jeffsponaugle/Kartana3/images/ALUSchematicPage1.png

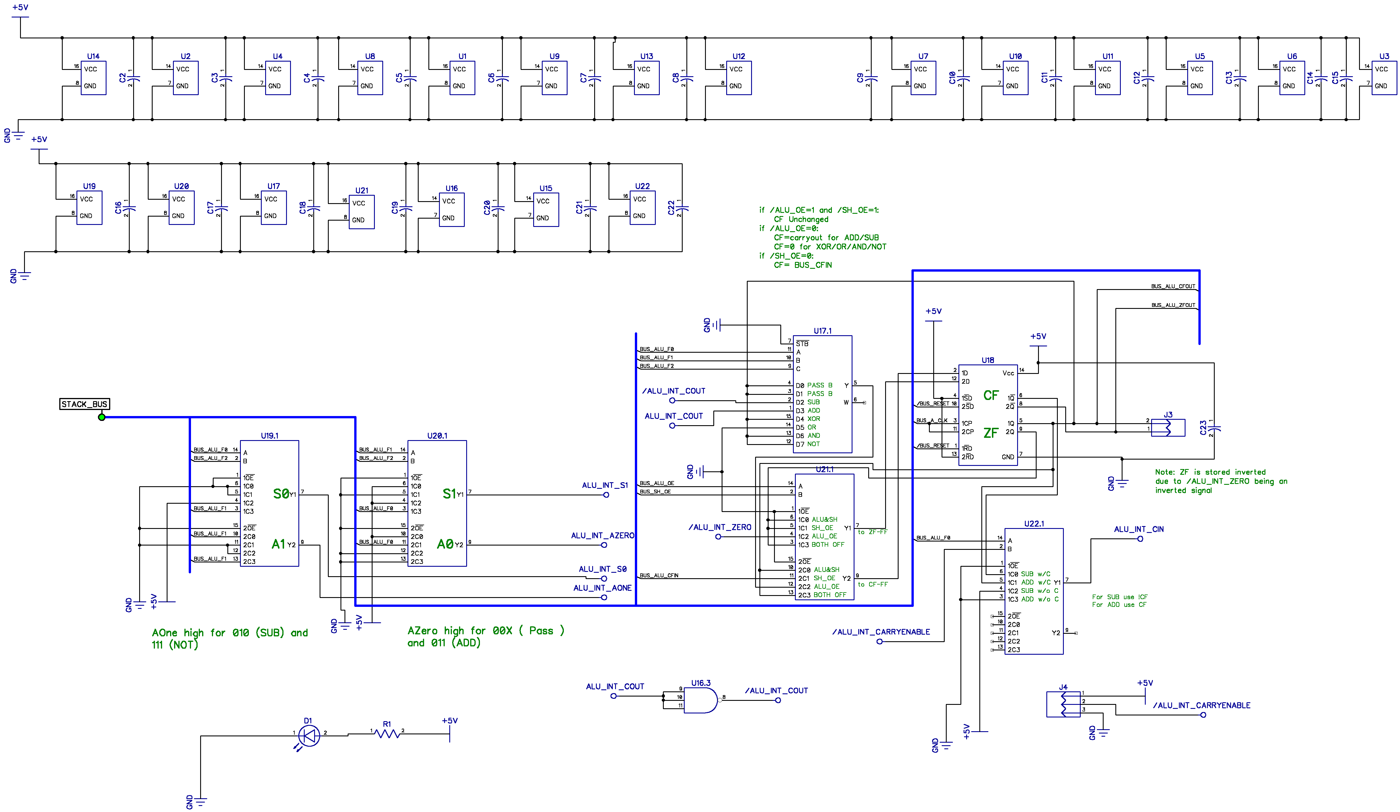
images/ALUSchematicPage1.png
