jeffsponaugle/Kartana3/images/ALUSchematicPage2.png

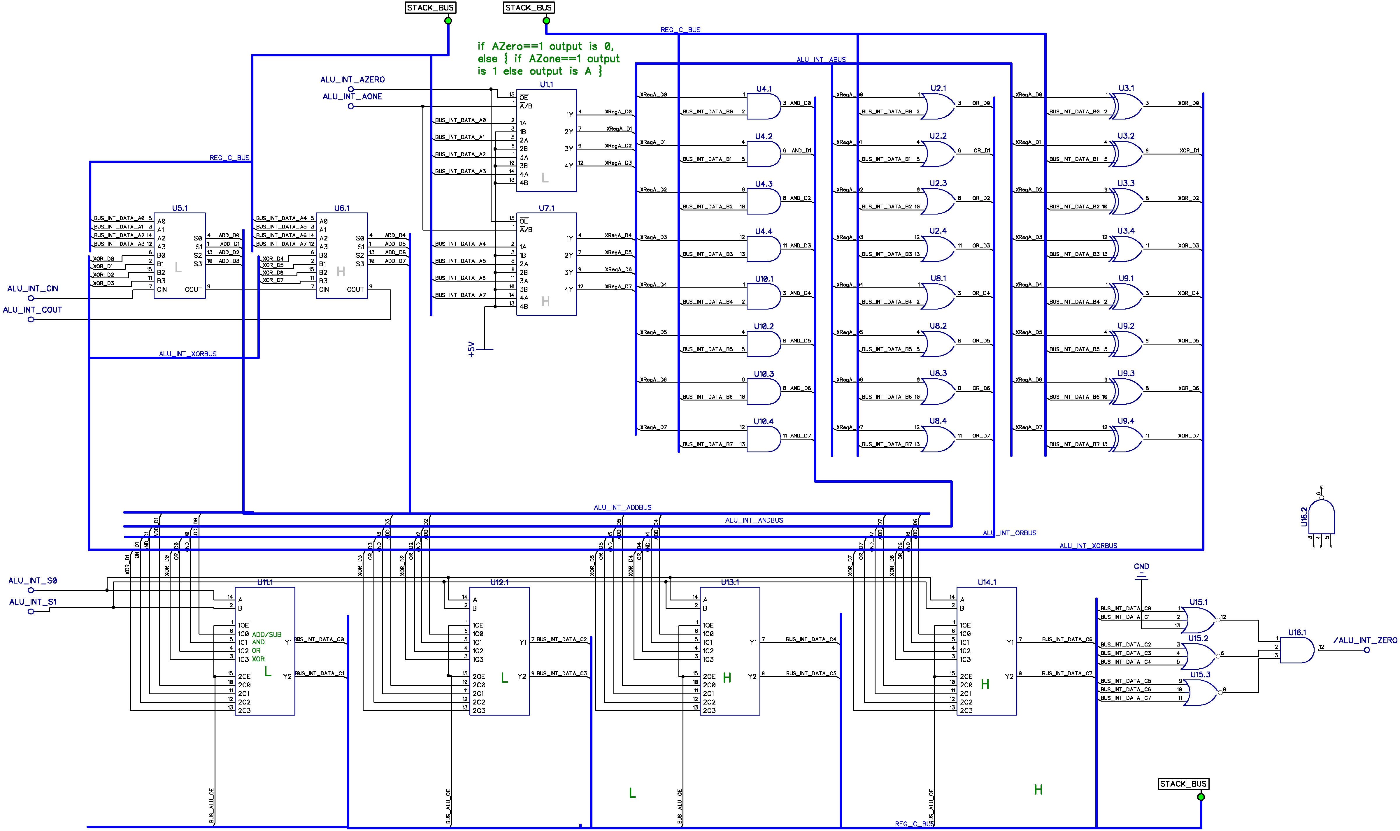
images/ALUSchematicPage2.png
