jeffsponaugle/Kartana3/images/MemoryPage1.png

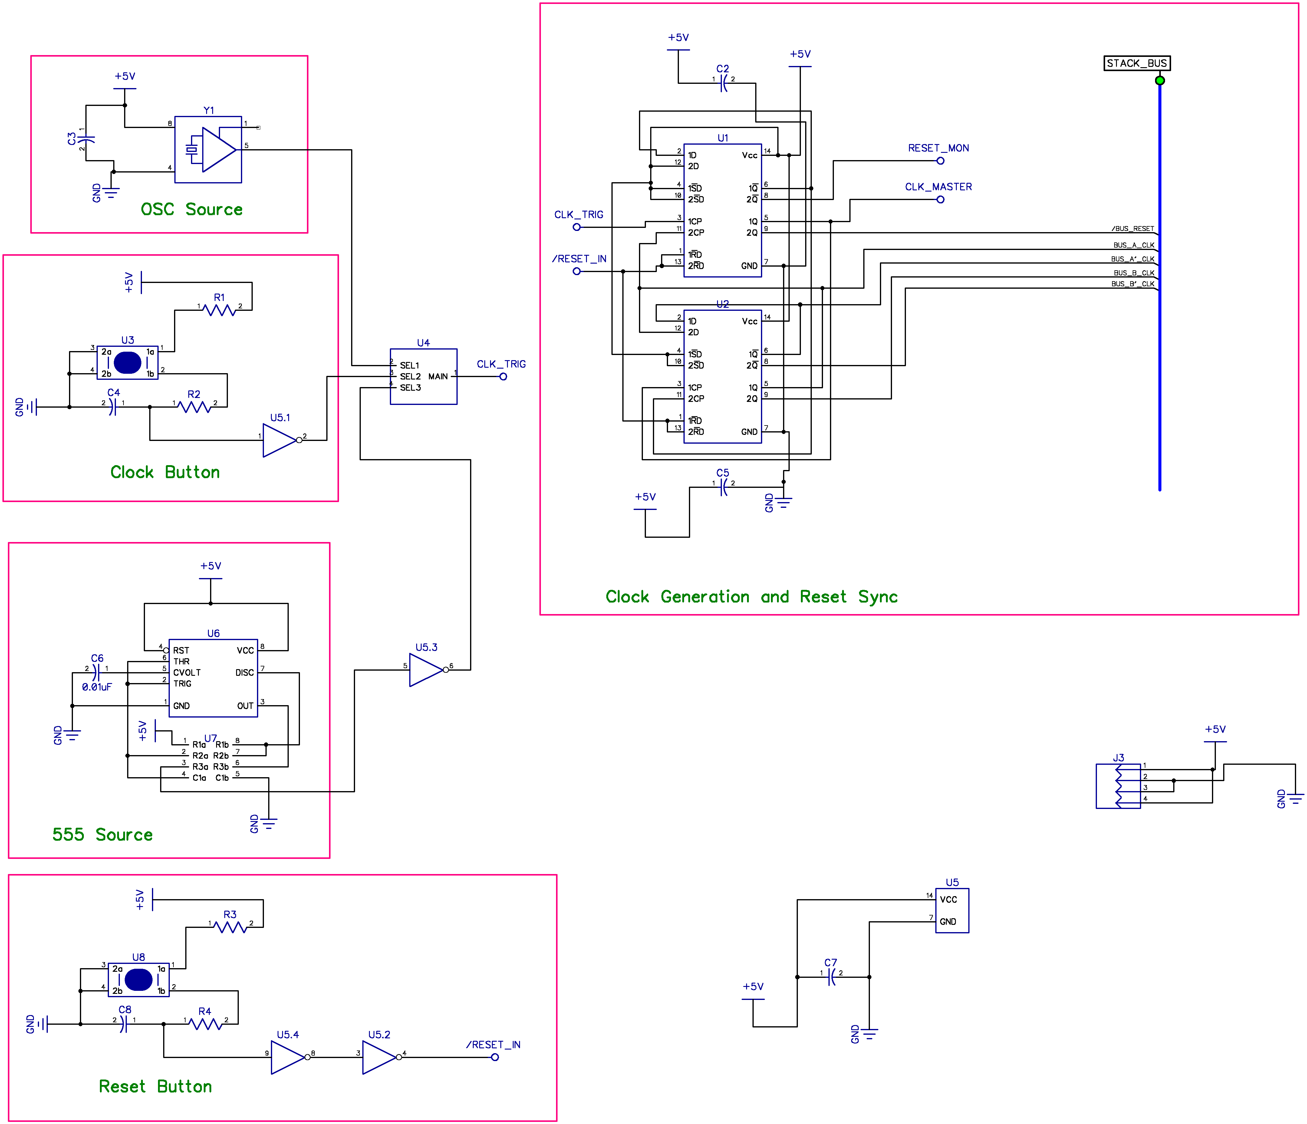
images/MemoryPage1.png
