jeffsponaugle/Kartana3/images/MemoryPage2.png

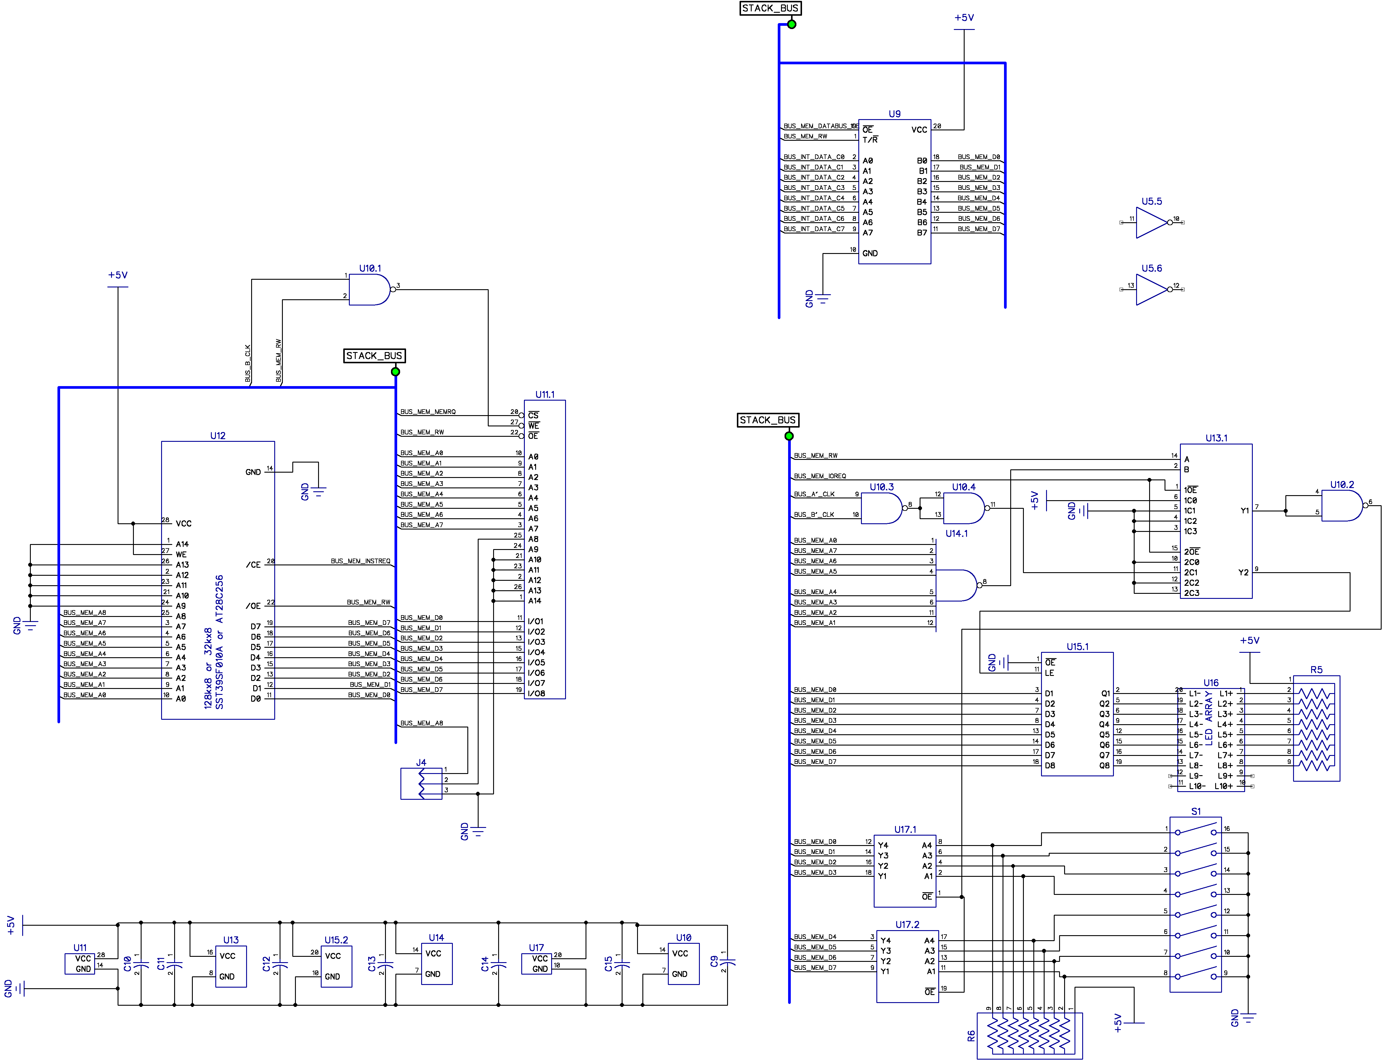
images/MemoryPage2.png
