jeffsponaugle/Kartana3/images/MemoryPage3.png

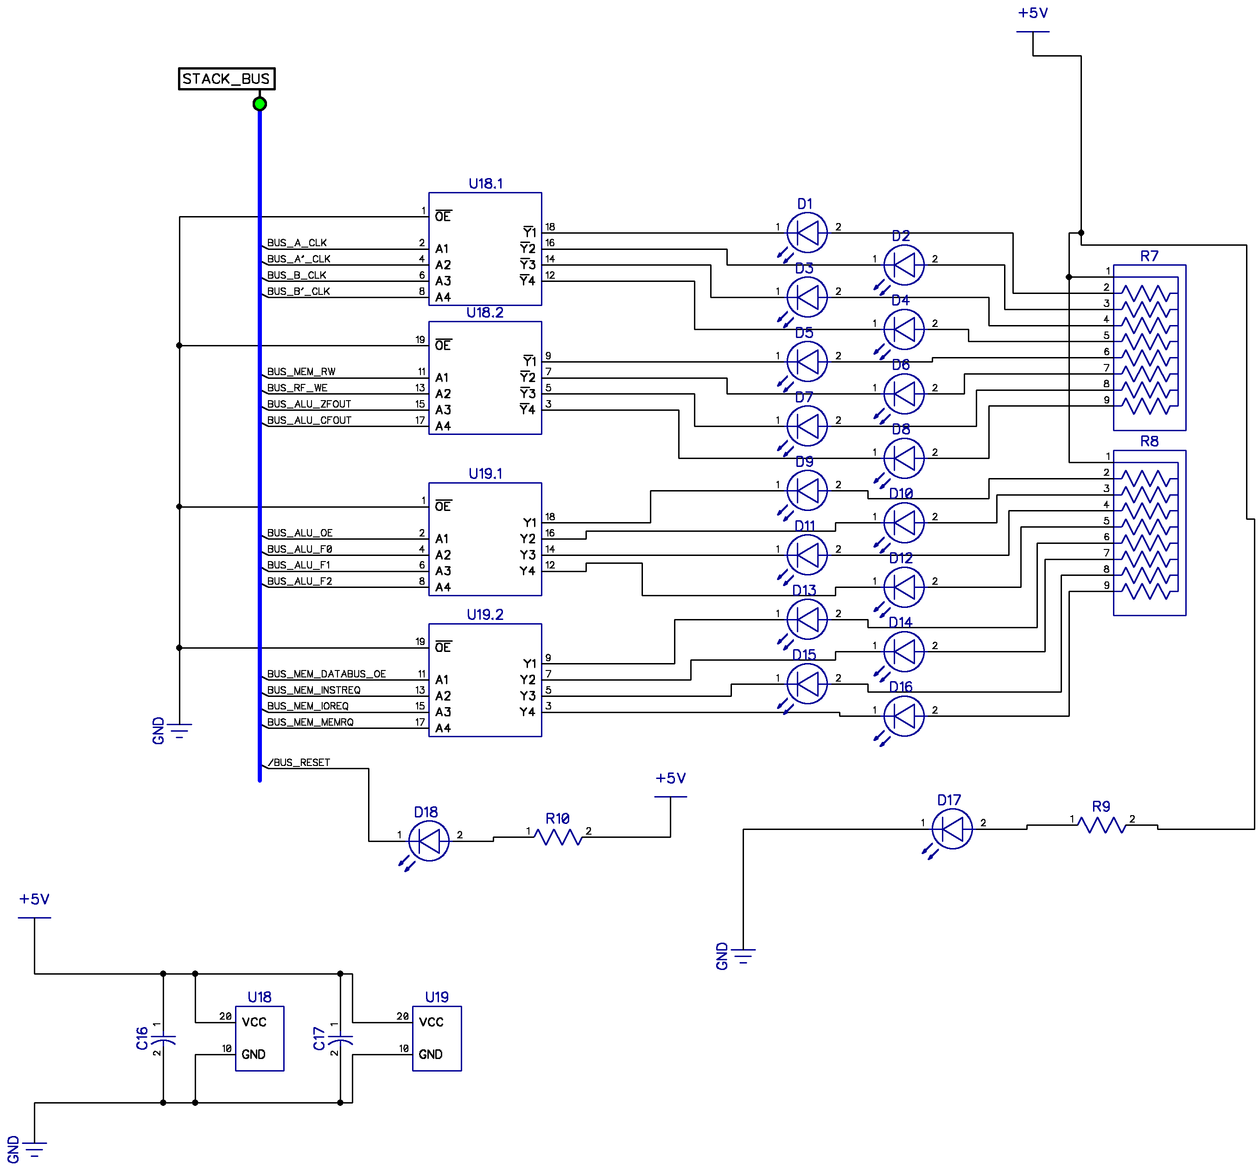
images/MemoryPage3.png
