jeffsponaugle/Kartana3/(list of files, drawings)

Other design files:
Schematic/MasterCPUR3-ALU.dch
Schematic/MasterCPUR3-ControlBoard.dch
Schematic/MasterCPUR3-Memory.dch
Schematic/MasterCPUR3-RegFile.dch
Schematic/StackableALUR3.dip
Schematic/StackableControlBoardV3.dip
Schematic/StackableControlBoardV3Flipped.dip
Schematic/StackableMemoryR3.dip
Schematic/StackableRegFileR3.dip
