jeffsponaugle/Kartana3/Docs/MicroCPUInstructionWordUpdated.xlsx

Sheet: 8BitInstructionsR2
Instruction Word
OPCODE
15-12 | 11-8 | 7-4 | 3-0 | Mneumonic | Operation | Flags | Example
0000 | XXXX | XXXX | XXXX | NOP | No Operation | ~ | NOP -> 0x0000
0001 | cccc | imm 8 |  | LOADIMM c, imm8 | Load imm8 into Reg-c | ~ | LOADIMM R0,0 -> 0x1000
0010 | cccc | bbbb | aaaa | SUB a,b,c | Sub Reg-b from Reg-a, Store in Reg-c | ZF,CF | SUB R0,R1,R2 -> 0x2210
0011 | cccc | bbbb | aaaa | ADD a,b,c | Add Reg-a and Reg-b, Store in Reg-c | ZF,CF | ADD R1,R2,R3 -> 0x3321
0100 | cccc | bbbb | aaaa | XOR a,b,c | Logical XOR Reg-a and Reg-b, Store in Reg-c | ZF,CF=0 | XOR R2,R3,R4 -> 0x4432
0101 | cccc | bbbb | aaaa | OR a,b,c | Logical OR Reg-a and Reg-b, Store in Reg-c | ZF,CF=0 | OR R3,R4,R5 -> 0x5543
0110 | cccc | bbbb | aaaa | AND a,b,c | Logical AND Reg-a and Reg-b, Store in Reg-c | ZF,CF=0 | AND R4,R5,R6 -> 0x6654
0111 | cccc | bbbb | xxxx | NOT b,c | Logical NOT Reg-a into Reg-c | ZF,CF=0 | NOT R5, R6 -> 0x7650
1000 | cccc | imm 8 |  | STORE c, [imm8] | Store from Reg-c to memory address [imm8 0 extended] | ZF | STORE R1, [0x23] -> 0x8123
1001 | cccc | bbbb | aaaa | STORE c, [a,b] | Store from Reg-c to memory address in Reg-a:Reg-b | ZF | STORE R1, [R2,R3] -> 0x9231
1010 | cccc | imm 8 |  | LOAD c,[imm8] | Load from memory address [imm8 0 extended] to Reg-c | ~ | LOAD [0x24], R1 -> 0xA124
1011 | cccc | bbbb | aaaa | LOAD c,[a,b] | Load from memory address in Reg-a:Reg-b to Reg c | ~ | LOAD [R2,R3], R1 -> 0xB231
1100 | cccc | 0im3 | aaaa | SHL a,c, imm3 | c = a << im3 (into carry) | ~ | SHL R1, R2 -> 0xC201
1100 | cccc | 1im3 | aaaa | SHR a,c. imm3 | c = a >> im3 (with carry) | ~ | SHR R1, R2 -> 0xD201
1110 | 0jjj | imm 8 |  | JMP +imm8 | Jump Class of Instructions, imm8 relative | ~
 | 0000 | imm 8 |  | JMP +imm8
 | 0001 | imm 8 |  | JZ +imm8
 | 0010 | imm 8 |  | JNZ +imm8
 | 0011 | imm 8 |  | JC +imm8
 | 0100 | imm 8 |  | JNC +imm8
1110 | 1jjj | imm 8 |  | JMP imm8 | Jump Class of Instructions, imm8 absolute | ~
 | 1000 | imm 8 |  | JMP imm8
 | 1001 | imm 8 |  | JZ imm8
 | 1010 | imm 8 |  | JNZ imm8
 | 1011 | imm 8 |  | JC imm8
 | 1100 | imm 8 |  | JNC imm8
1111 | 0jjj | bbbb | aaaa | JMP [a,b] | Jump Class of Instructions, Register Absolute | ~
 | 0000 | bbbb | aaaa | JMP [a,b] | Jump (always) | ~ | JMP 0x67 -> 0xE067
 | 0001 | bbbb | aaaa | JZ [a,b] | Jump if ZF == 1 | ~ | JZ 0x67 -> 0xE167
 | 0010 | bbbb | aaaa | JNZ [a,b] | Jump if ZF == 0 | ~ | JNZ 0x67 -> 0xE267
 | 0011 | bbbb | aaaa | JC [a,b] | Jump if CF == 1 | ~ | JC 0x67 -> 0xE367
 | 0100 | bbbb | aaaa | JNC [a,b] | Jump if CF == 0 | ~ | JNC 0x67 -> 0xE467
 | 8 | 10 |  | OR R5,R5,R5 | 0x5555
 | 9 | 12 |  | ADD R0,R1,R0 | 0x3001
 | A | 14 |  | SUB R2,R1,R2 | 0x2212
 | B | 16 |  | JNC 11 | 0xF411
 | C | 18 |  | STORE R0,[0] | 0x8000
 | D | 1A |  | STORE R1,[0] | 0x8100
 | E | 1C |  | STORE R2,[0] | 0x8200
 | F | 1E |  | STORE R3,[0] | 0x8300
 | 10 | 20 |  | STORE R4,[0] | 0x8400
 | 11 | 22 |  | STORE R5,[0] | 0x8500
 |  |  |  | JMP 4 | 0xE004
 |  |  |  |  | 00 10 01 11 FA 12 FF 13 F2 90 00 74 03 94 F2 B4 55 55 01 30
 |  |  |  |  | 12 22 10 F4 00 80 00 81 00 82 00 83 00 84 00 85 04 E0
 |  |  |  |  | 00 10 01 11 FA 12 FF 13 02 90 02 B4 21 30 12 22 00 80 00 81 00 82 06 E0

Sheet: 16bitcontrolpinsA
K27CONTROLV5 |  | K27CONRTROLV5B |  | K27REGFILEV5 |  | ADDER8BITUPD
resetin | 1 | resetin | 1 | CSel0 | 1 | Y1 | 1
zf_in | 2 | CBus7 | 4 | CSel1 | 2 | F2 | 4
Addr0 | 4 | CBus6 | 5 | ABus0 | 4 | F1 | 5
Addr1 | 5 | CBus5 | 6 | CSel2 | 5 | F0 | 6
Addr2 | 6 | CBus4 | 8 | CSel3 | 6 | TDI | 7
Addr3 | 8 | CBus3 | 9 | TDI | 7 | ZeroFlag | 8
Addr4 | 9 | CBus2 | 10 | ASel3 | 8 | Z8 | 9
Addr5 | 10 | CBus1 | 11 | ASel2 | 9 | Z7 | 11
Addr6 | 11 | CBus0 | 12 | ASel1 | 11 | Z6 | 12
Addr7 | 12 | TDI | 14 | ASel0 | 12 | TMS | 13
TDI | 14 | CSel3 | 15 | TMS | 13 | Z5 | 14
Addr8 | 15 | CSel2 | 16 | BBus0 | 14 | Z4 | 16
Addr9 | 16 | CSel1 | 17 | ABus1 | 16 | Z3 | 17
Addr10 | 17 | CSel0 | 18 | BSel3 | 17 | Z2 | 18
Addr11 | 18 | BSel3 | 20 | BSel2 | 18 | Z1 | 19
Addr12 | 20 | BSel2 | 21 | BSel1 | 19 | X8 | 20
Addr13 | 21 | BSel1 | 22 | BBus1 | 20 | X7 | 21
Addr14 | 22 | TMS | 23 | WriteEnable | 21 | X6 | 24
TMS | 23 | BSel0 | 24 | BSel0 | 24 | X5 | 25
Addr15 | 24 | ASel3 | 25 | CBus0 | 29 | X4 | 26
Addr16 | 25 | ASel2 | 27 | CBus1 | 31 | X3 | 27
uS0 | 27 | ASel1 | 28 | TCK | 32 | X2 | 28
uS1 | 28 | ASel0 | 29 | TDO | 38 | X1 | 29
Aclk | 29 | OPCode3 | 30 | clkin | 43 | CFlag | 31
Bclk | 30 | OPCode2 | 31 | CBus_OE | 44 | TCK | 32
Bprimeclk | 31 | OPCode1 | 33 |  |  | Y8 | 33
Aprimeclk | 33 | OPCode0 | 34 |  |  | Y7 | 34
resetout | 34 | rf_we | 35 |  |  | Y6 | 36
clk_master | 35 | alu_oe | 36 |  |  | Y5 | 37
IDRL0 | 36 | ABToAddrBus | 37 |  |  | TDO | 38
IDRL1 | 37 | IDRToAddrBus | 39 |  |  | Y4 | 39
IDRL2 | 39 | mem_rw | 40 |  |  | Y3 | 40
IDRL3 | 40 | rf_COE | 41 |  |  | Y2 | 41
IDRL4 | 41 | uS1 | 44 |  |  | clk_in | 43
IDRL5 | 44 | uS0 | 45 |  |  | ALU_OE | 44
IDRL6 | 45 | mem_instreq | 46
IDRL7 | 46 | mem_oe | 48
IDRH0 | 48 | mem_memreq | 49
IDRH1 | 49 | sh_oe | 50
IDRH2 | 50 | Databus7 | 51
IDRH3 | 51 | Databus6 | 52
IDRH4 | 52 | Databus5 | 54
IDRH5 | 54 | Databus4 | 55
IDRH6 | 55 | Databus3 | 56
IDRH7 | 56 | Databus2 | 57
ABtoAddrB | 57 | Databus1 | 58
ABus0 | 58 | Databus0 | 60
ABus1 | 60 | TCK | 62
ABus2 | 61 | TDO | 71
TCK | 62 | Bprimeclk | 83
ABus3 | 63
ABus4 | 64
ABus5 | 65
ABus6 | 67
ABus7 | 68
BBus0 | 69
BBus1 | 70
TDO | 71
BBus2 | 73
BBus3 | 74
BBus4 | 75
BBus5 | 76
BBus6 | 77
BBus7 | 79
IDRtoAddrB | 80
cf_in | 81
clk_in | 83

Sheet: 8BitInstructions
Instruction Word
OPCODE
15-12 | 11-8 | 7-4 | 3-0 | Mneumonic | Operation | Flags | Example
0000 | XXXX | XXXX | XXXX | NOP | No Operation | ~ | NOP -> 0x0000
0001 | cccc | imm 8 |  | LOADIMM c, imm8 | Load imm8 into Reg-c | ~ | LOADIMM R0,0 -> 0x1000
0010 | cccc | bbbb | aaaa | SUB a,b,c | Sub Reg-b from Reg-a, Store in Reg-c | ZF,CF | SUB R0,R1,R2 -> 0x2210
0011 | cccc | bbbb | aaaa | ADD a,b,c | Add Reg-a and Reg-b, Store in Reg-c | ZF,CF | ADD R1,R2,R3 -> 0x3321
0100 | cccc | bbbb | aaaa | XOR a,b,c | Logical XOR Reg-a and Reg-b, Store in Reg-c | ZF,CF=0 | XOR R2,R3,R4 -> 0x4432
0101 | cccc | bbbb | aaaa | OR a,b,c | Logical OR Reg-a and Reg-b, Store in Reg-c | ZF,CF=0 | OR R3,R4,R5 -> 0x5543
0110 | cccc | bbbb | aaaa | AND a,b,c | Logical AND Reg-a and Reg-b, Store in Reg-c | ZF,CF=0 | AND R4,R5,R6 -> 0x6654
0111 | cccc | bbbb | xxxx | NOT b,c | Logical NOT Reg-a into Reg-c | ZF,CF=0 | NOT R5, R6 -> 0x7650
1000 | cccc | imm 8 |  | STORE c, [imm8] | Store from Reg-c to memory address imm8 | ZF | STORE R1, [0x23] -> 0x8123
1001 | cccc | 1111 | aaaa | STORE c, [a] | Store from Reg-c to memory address in Reg-a | ZF | STORE R1, [R2] -> 0x9201
 | cccc | 0000 | aaaa | STOREIO c, [a] |  | ZF | STOREIO R1, [R2] -> 0x9211
1010 | cccc | imm 8 |  | LOAD c,[imm8] | Load from memory address imm8 to Reg-c | ~ | LOAD [0x24], R1 -> 0xA124
1011 | cccc | 1111 | aaaa | LOAD c,c | Load from memory address in Reg-a to Reg c | ~ | LOAD [R2], R1 -> 0xB201
 | cccc | 0000 | aaaa | LOADIO c,[a] |  | ~ | LOADIO [R2], R1 -> 0xB211
1100 | cccc | 0000 | aaaa | SHL a,c | c = a << 1 | ~ | SHL R1, R2 -> 0xC201
1101 | cccc | 0000 | aaaa | SHR a,c | c = a >> 1 (with carry) | ~ | SHR R1, R2 -> 0xD201
1110 | 0jjj | imm 8 |  | JMP +imm8 | Jump Class of Instructions, Relative | ~
1111 | 0jjj | imm 8 |  | JMP imm8 | Jump Class of Instructions, Absolute | ~
 | 0000 | imm 8 |  | JMPA | Jump (always) | ~ | JMP 0x67 -> 0xE067
 | 0001 | imm 8 |  | JZ | Jump if ZF == 1 | ~ | JZ 0x67 -> 0xE167
 | 0010 | imm 8 |  | JNZ | Jump if ZF == 0 | ~ | JNZ 0x67 -> 0xE267
 | 0011 | imm 8 |  | JC | Jump if CF == 1 | ~ | JC 0x67 -> 0xE367
 | 0100 | imm 8 |  | JNC | Jump if CF == 0 | ~ | JNC 0x67 -> 0xE467
Light Grey instructions are decoded but not implemented in the first version.
 | 8 | 10 |  | OR R5,R5,R5 | 0x5555
 | 9 | 12 |  | ADD R0,R1,R0 | 0x3001
 | A | 14 |  | SUB R2,R1,R2 | 0x2212
 | B | 16 |  | JNC 11 | 0xF411
 | C | 18 |  | STORE R0,[0] | 0x8000
 | D | 1A |  | STORE R1,[0] | 0x8100
 | E | 1C |  | STORE R2,[0] | 0x8200
 | F | 1E |  | STORE R3,[0] | 0x8300
 | 10 | 20 |  | STORE R4,[0] | 0x8400
 | 11 | 22 |  | STORE R5,[0] | 0x8500
 |  |  |  | JMP 4 | 0xE004
 |  |  |  |  | 00 10 01 11 FA 12 FF 13 F2 90 00 74 03 94 F2 B4 55 55 01 30
 |  |  |  |  | 12 22 10 F4 00 80 00 81 00 82 00 83 00 84 00 85 04 E0
 |  |  |  |  | 00 10 01 11 FA 12 FF 13 02 90 02 B4 21 30 12 22 00 80 00 81 00 82 06 E0

Sheet: 8BitMicrocodeSimulation
 |  |  |  |  |  | Bitfield
 | uCodeA | uState | OpCode |  | Desc | /PC_LOAD | PC_INC | /IDR_ENABLE_L | /IDR_ENABLE_H | RF_WE | ALU_FUNC/3 | /ALU_OE | /BUF_IDRTOCBUS | /RF_ATOADDR | /BUF_IDRTOADDR | /BUF_DB_OE | /SH_OE | SH_DIR | D_MEM_RW | /MEM_MEMREQ | /MEM_IOREQ | /MEM_INSTREQ | uState
FETCH | 00000 | 00 | xxxx |  | Fetch L | 1 | 0 | 0 | 1 | 0 | xxx | 1 | 1 | 1 | 1 | 1 | 1 | x | 0 | 1 | 1 | 0 | 00
FETCH | 00001 | 01 | xxxx |  | Fetch H | 1 | 0 | 1 | 0 | 0 | xxx | 1 | 1 | 1 | 1 | 1 | 1 | x | 0 | 1 | 1 | 0 | 01
 |  | 10 | 0000 | 00 | NOP (Execute) | 1 | 1 | 1 | 1 | 0 | xxx | 1 | 1 | 1 | 1 | 1 | 1 | x | 0 | 1 | 1 | 1 | 10
 | 00010 | 10 | 0001 | 00 | LOADIMM c,imm8 | 1 | 1 | 1 | 1 | 1 | xxx | 1 | 0 | 1 | 1 | 1 | 1 | x | 0 | 1 | 1 | 1 | 10
 | 00011 |  |  |  | unused
 | 00100 | 10 | 0010 | 01 | SUB a,b,c | 1 | 1 | 1 | 1 | 1 | 010 | 0 | 1 | 1 | 1 | 1 | 1 | x | 0 | 1 | 1 | 1 | 10
 | 00101 |  |  |  | unused
 | 00110 | 10 | 0011 | 01 | ADD a,b,c | 1 | 1 | 1 | 1 | 1 | 011 | 0 | 1 | 1 | 1 | 1 | 1 | x | 0 | 1 | 1 | 1 | 10
 | 00111 |  |  |  | unused
 | 01000 | 10 | 0100 | 10 | XOR a,b,c | 1 | 1 | 1 | 1 | 1 | 100 | 0 | 1 | 1 | 1 | 1 | 1 | x | 0 | 1 | 1 | 1 | 10
 | 01001 |  |  |  | unused
 | 01010 | 10 | 0101 | 10 | OR a,b,c | 1 | 1 | 1 | 1 | 1 | 101 | 0 | 1 | 1 | 1 | 1 | 1 | x | 0 | 1 | 1 | 1 | 10
 | 01011 |  |  |  | unused
 | 01100 | 10 | 0110 | 11 | AND a,b,c | 1 | 1 | 1 | 1 | 1 | 110 | 0 | 1 | 1 | 1 | 1 | 1 | x | 0 | 1 | 1 | 1 | 10
 | 01101 |  |  |  | unused
 | 01110 | 10 | 0111 | 11 | NOT a,c | 1 | 1 | 1 | 1 | 1 | 111 | 0 | 1 | 1 | 1 | 1 | 1 | x | 0 | 1 | 1 | 1 | 10
 | 01111 |  |  |  | unused
 | 10000 | 10 | 1000 | 00 | STORE c,[imm8] | 1 | 1 | 1 | 1 | 0 | 000 | 0 | 1 | 1 | 0 | 0 | 1 | x | 1 | 0 | 1 | 1 | 10
 | 10001 |  |  |  | unused
 | 10010 | 10 | 1001 | 00 | STORE c,[a] | 1 | 1 | 1 | 1 | 0 | 001 | 0 | 1 | 0 | 1 | 0 | 1 | x | 1 | 0 | 1 | 1 | 10
 |  |  |  |  | STOREIO c, [a] | 1 | 1 | 1 | 1 | 0 | 001 | 0 | 1 | 0 | 1 | 0 | 1 | x | 1 | 1 | 0 | 1 | 10
 | 10011 |  |  |  | unused
 | 10100 | 10 | 1010 | 01 | LOAD c,[imm8] | 1 | 1 | 1 | 1 | 1 | xxx | 1 | 1 | 1 | 0 | 0 | 1 | x | 0 | 0 | 1 | 1 | 10
 | 10101 |  |  |  | unused
 | 10110 | 10 | 1011 | 01 | LOAD c,[a] | 1 | 1 | 1 | 1 | 1 | xxx | 1 | 1 | 0 | 1 | 0 | 1 | x | 0 | 0 | 1 | 1 | 10
 |  |  |  |  | LOADIO c, [a] | 1 | 1 | 1 | 1 | 1 | xxx | 1 | 1 | 0 | 1 | 0 | 1 | x | 0 | 1 | 0
 | 10111 |  |  |  | unused
 | 11000 | 10 | 1100 | 10 | SHL a,c | 1 | 1 | 1 | 1 | 1 | xxx | 1 | 1 | 1 | 1 | 1 | 0 | 0 | 0 | 1 | 1 | 1 | 10
 | 11001 |  |  |  | unused
 | 11010 | 10 | 1101 | 10 | SHR s,c | 1 | 1 | 1 | 1 | 1 | xxx | 1 | 1 | 1 | 1 | 1 | 0 | 1 | 0 | 1 | 1 | 1 | 10
 | 11011 |  |  |  | unused
 | 11100 | 10 | 1110 | 11 | JMP {cc} imm8 | 0*cc | 1 | 1 | 1 | 0 | xxx | 1 | 1 | 1 | 1 | 1 | 1 | x | 0 | 1 | 1 | 1 | 10
 | 11101 |  |  |  | unused
 | 11110 | 10 | 1111 | 11 | JMP {cc} +imm8s | 0*cc | 1 | 1 | 1 | 0 | xxx | 1 | 1 | 1 | 1 | 1 | 1 | x | 0 | 1 | 1 | 1 | 10
 | 11111 |  |  |  | unused
 | uState
 | 00 |  | Fetch0 |  | BUF_DB_DIR
 | 01 |  | Fetch1 |  | 0=From Memory
 | 10 |  | Execute |  | 1=To Memory
 |  |  |  | ALU_FUNC
 |  |  |  | 000 | PASS B
 |  |  |  | 001 | PASS B
 |  |  |  | 010 | SUB A-B
 |  |  |  | 011 | ADD A+B
 |  |  |  | 100 | XOR A x B
 |  |  |  | 101 | OR A or B
 |  |  |  | 110 | AND A and B
 |  |  |  | 111 | NOT B
 |  |  |  |  | zQ%E87bq$Iou

Sheet: CPLD Pinouts
REGFILE CPLD |  | ALU CPLD |  | CONTROL CPLD |  | MEM CPLD |  | 4x7SEG CPLD
BBus1 | 4 | ALU_OE | 44 | resetin | 1 | A1 | 1 | A0 | 2
WriteEnable | 5 | CFlag | 31 | CF_in | 2 | A2 | 2 | A1 | 4
TDI | 7 | clk_in | 43 | mem_rw | 4 | A3 | 4 | A2 | 5
ABus1 | 8 | F0 | 6 | rf_atoaddr | 5 | A4 | 5 | A3 | 6
CBus1 | 11 | F1 | 5 | sh_oe | 6 | A5 | 6 | B0 | 8
CBus0 | 12 | F2 | 4 | rf_we | 8 | TDI | 7 | B1 | 9
TMS | 13 | TCK | 32 | alu_oe | 9 | A6 | 8 | B2 | 11
ABus0 | 17 | TDI | 7 | CBus0 | 10 | A7 | 9 | B3 | 12
ASel3 | 18 | TDO | 38 | CBus1 | 11 | A8 | 11 | C0 | 14
ASel2 | 19 | TMS | 13 | CBus2 | 12 | A9 | 12 | C1 | 16
ASel1 | 20 | X1 | 29 | TDI | 14 | TMS | 13 | C2 | 17
ASel0 | 21 | X2 | 28 | CBus3 | 15 | A10 | 14 | C3 | 18
CSel0 | 24 | X3 | 27 | CBus4 | 16 | A11 | 16 | clk | 43
CSel1 | 25 | X4 | 26 | CBus5 | 17 | A12 | 17 | D0 | 19
CSel2 | 26 | X5 | 25 | CBus6 | 18 | A13 | 18 | D1 | 20
CSel3 | 27 | X6 | 24 | CBus7 | 20 | A14 | 19 | D2 | 21
TCK | 32 | X7 | 21 | AddrBus0 | 21 | A15 | 20 | D3 | 24
BSel3 | 33 | X8 | 20 | AddrBus1 | 22 | A16 | 21 | LEA | 26
BSel2 | 34 | Y1 | 1 | TMS | 23 | ledlatchen | 24 | LEB | 27
BSel1 | 36 | Y2 | 41 | AddrBus2 | 24 | iocs0 | 25 | LEC | 28
BSel0 | 37 | Y3 | 40 | AddrBus3 | 25 | iocs1 | 26 | LED | 29
TDO | 38 | Y4 | 39 | AddrBus4 | 27 | iocs2 | 27 | SEGA | 31
BBus0 | 41 | Y5 | 37 | AddrBus5 | 28 | iocs3 | 28 | SEGB | 33
clkin | 43 | Y6 | 36 | AddrBus6 | 29 | TCK | 32 | SEGC | 34
 |  | Y7 | 34 | AddrBus7 | 30 | ms8or16 | 33 | SEGD | 36
 |  | Y8 | 33 | AddrBus8 | 31 | ram_ce | 34 | SEGE | 37
 |  | Z1 | 19 | CSel0 | 33 | ram_we | 36 | SEGF | 39
 |  | Z2 | 18 | CSel1 | 34 | mem_rw | 37 | SEGG | 40
 |  | Z3 | 17 | CSel2 | 35 | TDO | 38 | TCK | 32
 |  | Z4 | 16 | CSel3 | 36 | ioreq | 39 | TDI | 7
 |  | Z5 | 14 | OPCode0 | 37 | memreq | 40 | TDO | 38
 |  | Z6 | 12 | OPCode1 | 39 | b_clk | 41 | TMS | 13
 |  | Z7 | 11 | OPCode2 | 40 | A0 | 44
 |  | Z8 | 9 | OPCode3 | 41
 |  | ZeroFlag | 8 | ASel0 | 44
 |  |  |  | ASel1 | 45
 |  |  |  | uS1 | 46
 |  |  |  | ASel2 | 48
 |  |  |  | uS0 | 49
 |  |  |  | ASel3 | 50
 |  |  |  | mem_ioreq | 51
 |  |  |  | mem_memreq | 52
 |  |  |  | mem_oe | 54
 |  |  |  | mem_instreq | 55
 |  |  |  | BSel0 | 56
 |  |  |  | BSel1 | 57
 |  |  |  | BSel2 | 58
 |  |  |  | BSel3 | 60
 |  |  |  | Databus0 | 61
 |  |  |  | TCK | 62
 |  |  |  | Databus1 | 63
 |  |  |  | Databus2 | 64
 |  |  |  | Databus3 | 65
 |  |  |  | Databus4 | 67
 |  |  |  | Databus5 | 68
 |  |  |  | Databus6 | 69
 |  |  |  | Databus7 | 70
 |  |  |  | TDO | 71
 |  |  |  | clk_master | 75
 |  |  |  | Bprimeclk | 76
 |  |  |  | Aprimeclk | 77
 |  |  |  | resetout | 79
 |  |  |  | Aclk | 80
 |  |  |  | Bclk | 81
 |  |  |  | clk_in | 83
 |  |  |  | ZF_in | 84

Sheet: Sheet4
 |  | FETCH | EXECUTE |  | FETCH | EXECUTE
A
B
A'
B'
A_SEL (incoming) | PREV > | < UNDEFINED > | < VALID >
C_SEL (incoming) | PREV > | < UNDEFINED > | < VALID >
REG_WE (incoming) | PREV > |  |  |  |  | < UNDEFINED >
REG_INT_WRITE (internal) |  |  |  |  |  | < UNDEFINED >
REG_INT_C_BUFFERENABLE (internal) |  |  |  |  |  | < UNDEFINED >
SRAM_/WE |  |  |  |  |  | < UNDEFINED >
SRAM_/OE |  |  |  |  |  | < UNDEFINED >
SRAM ADDRESS BUS SRC |  |  | < A_SEL> | < C_SEL>
A_REG_/LE |  |  |  |  |  | < UNDEFINED >

Sheet: Sheet7
 |  | Inputs |  |  |  |  |  | Outputs
 |  | F2,F0 | F1 | F2,F1 | F0 | /CarryEnable | /ALU_OE | S1 | S0 | selects | Azero | Aone | Cfin | Zfin | ALU_Cin
000 | PASS B | 00 | 0 | X | 0 | 1 | 0 | 1 | 0 | OR | 1 | 0 | CF | Zfcalc | 1
001 | PASS B | 01 | 0 | 00 | 1 | 1 | 0 | 1 | 0 | OR | 1 | 0 | CF | Zfcalc | 0
010 | SUB A-B | 00 | 1 | 01 | 0 | 1 | 0 | 0 | 0 | ADDER | 0 | 1 | ADDER_COUT | Zfcalc | 1
011 | ADD A+B | 01 | 1 | 01 | 1 | 1 | 0 | 0 | 0 | ADDER | 1 | 0 | ADDER_COUT | Zfcalc | 0
100 | XOR A x B | 10 | 0 | 10 | 0 | 1 | 0 | 1 | 1 | XOR | 0 | 0 | CF | Zfcalc | 1
101 | OR A or B | 11 | 0 | 10 | 1 | 1 | 0 | 1 | 0 | OR | 0 | 0 | CF | Zfcalc | 0
110 | AND A and B | 10 | 1 | 11 | 0 | 1 | 0 | 0 | 1 | AND | 0 | 0 | CF | Zfcalc | 1
111 | NOT B | 11 | 1 | 11 | 1 | 1 | 0 | 1 | 1 | XOR | 0 | 1 | CF | Zfcalc | 0
ALU_OE only effects flag reloading, other operations stay the same.
000 | PASS B | 00 | 0 | 00 | 0 |  | 1 |  |  |  |  |  | CF | ZF
001 | PASS B | 01 | 0 | 00 | 1 |  | 1 |  |  |  |  |  | CF | ZF
010 | SUB A-B | 00 | 1 | 01 | 0 |  | 1 |  |  |  |  |  | CF | ZF
011 | ADD A+B | 01 | 1 | 01 | 1 |  | 1 |  |  |  |  |  | CF | ZF
100 | XOR A x B | 10 | 0 | 10 | 0 |  | 1 |  |  |  |  |  | CF | ZF
101 | OR A or B | 11 | 0 | 10 | 1 |  | 1 |  |  |  |  |  | CF | ZF
110 | AND A and B | 10 | 1 | 11 | 0 |  | 1 |  |  |  |  |  | CF | ZF
111 | NOT B | 11 | 1 | 11 | 1 |  | 1 |  |  |  |  |  | CF | ZF
CarryEnable only effects the ALU_Cin configuration
000 | PASS B | 00 | 0 | 00 | 0 | 0 |  |  |  |  |  |  |  |  | ~CF
001 | PASS B | 01 | 0 | 00 | 1 | 0 |  |  |  |  |  |  |  |  | CF
010 | SUB A-B | 00 | 1 | 01 | 0 | 0 |  |  |  |  |  |  |  |  | ~CF
011 | ADD A+B | 01 | 1 | 01 | 1 | 0 |  |  |  |  |  |  |  |  | CF
100 | XOR A x B | 10 | 0 | 10 | 0 | 0 |  |  |  |  |  |  |  |  | ~CF
101 | OR A or B | 11 | 0 | 10 | 1 | 0 |  |  |  |  |  |  |  |  | CF
110 | AND A and B | 10 | 1 | 11 | 0 | 0 |  |  |  |  |  |  |  |  | ~CF
111 | NOT B | 11 | 1 | 11 | 1 | 0 |  |  |  |  |  |  |  |  | CF
